noqsi/Mcadam/ICD/State.png

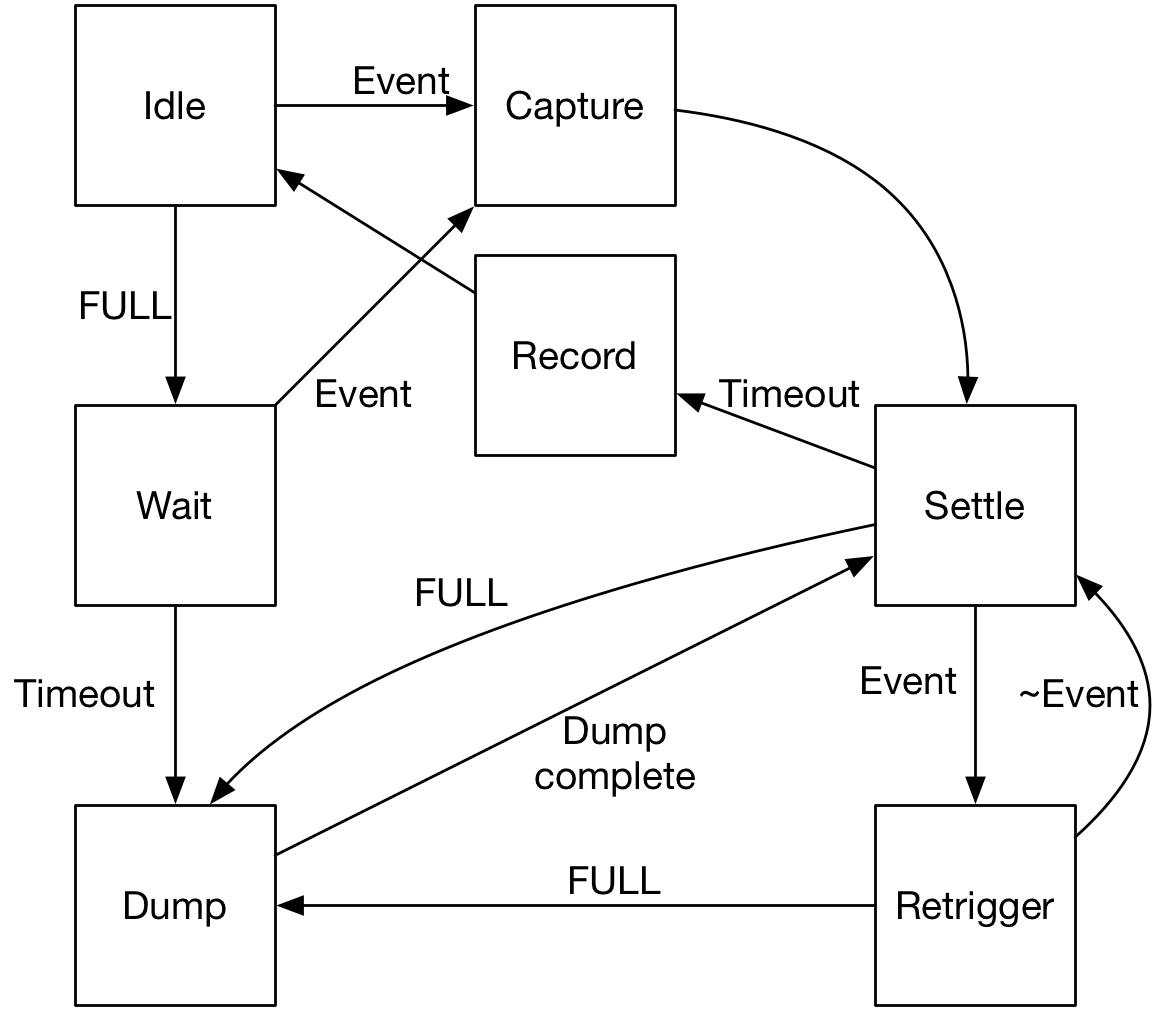
ICD/State.png
