noqsi/Mcadam/GSE/Doc/GSEhookup.graffle.pdf

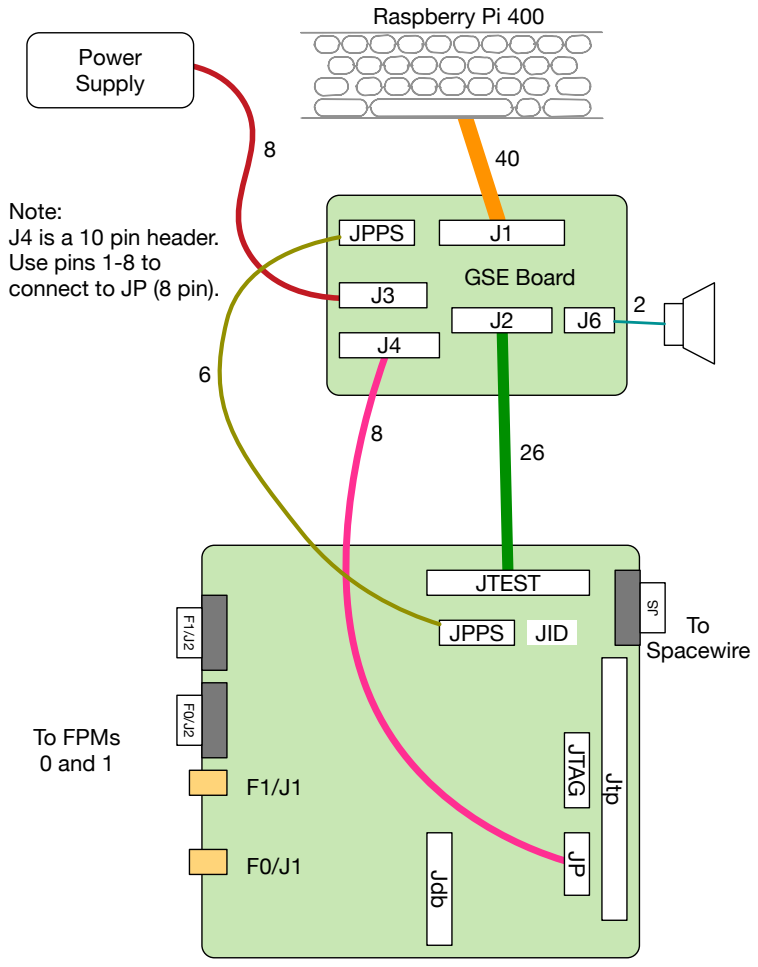
[picture p2: page 1]
JPPS; Raspberry Pi 400; GSE Board; JTEST; Jtp; JTAG; JID; Jdb; Power Supply; To FPMs 0 and 1; To Spacewire

Note:
J4 is a 10 pin header.
Use pins 1-8 to
connect to JP (8 pin).
