noqsi/Mcadam/ICD/test_if.txt

//============================================================================//
//--- Module Name: test_if
//
//--- Description: GSE Test Interface
//
// Test connector
// - pin  1 input  SPI0_MOSI
// - pin  2 output SPI0_MISO
// - pin  3 input  SPI0_SCLK
// - pin  4 input  SPI0_CE0_N
// - pin  5 input  SPI0_CE1_N
// - pin  6 input  SPI0_MOSI    - unused
// - pin  7 output SPI1_MISO
// - pin  8 input  SPI1_SCLK
// - pin  9 input  SPI1_CE0_N
// - pin 10 input  FORCE0       - pulse to force FPM0 event
// - pin 11 input  FORCE1       - pulse to force FPM1 event
// - pin 12 output EVENT_RDY    - goes high when event ready; low after SPI1 readout
// - pin 13 input  TEST_ENABLE  - set high to enable test interface
//
// GSE is SPI master, FPGA is slave
//
// SPI0 *****************************************
// - 16-bit transfers
// - CE0 : MOSI=ADR_REG  MISO=ADR_REG(last)
// - CE1 : MOSI=WR_REG   MISO=RD_REG
//
// ADR_REG
//  bits 15-8: 8-bit WADR
//        7-0: 8-bit RADR
//
// ADR R/W Description
// x00 rw   null (no write)
// x01 rw   MODE
//           [    0] 0=off, 1=photons
// x02 rw   HV_CTRL
//           [    0] 0=off, 1=on
// x03 rw   DAC_DATA
//           [15: 0] AD5328 DAC data
// x10 rw   FPM0_FAST_ADC_GAIN
//           [ 2: 0] 2^N ADC gain
// x11 rw   FPM0_FAST_ADC_OFFSET
//           [15: 0] 16-bit ADC offset
// x12 rw   FPM0_SLOW_ADC_GAIN
// x13 rw   FPM0_SLOW_ADC_OFFSET
// x20 rw   FPM1_FAST_ADC_GAIN
// x21 rw   FPM1_FAST_ADC_OFFSET
// x22 rw   FPM1_SLOW_ADC_GAIN
// x23 rw   FPM1_SLOW_ADC_OFFSET
// x30 r    HK_0_0 (FLLD-0)
// x31 r    HK_0_1 (SLLD-0)
// x32 r    HK_0_2 (TEMP-0)
// x33 r    HK_0_3 (HOT-0)
// x34 r    HK_0_4 (HVHK-0)
// x35 r    HK_0_5 (TIS-0)
// x36 r    HK_0_6 (TVS-0)
// x37 r    HK_0_7 (unused)
// x38 r    HK_1_0 (FLLD-1)
// x39 r    HK_1_1 (SLLD-1)
// x3A r    HK_1_2 (TEMP-1)
// x3B r    HK_1_3 (HOT-1)
// x3C r    HK_1_4 (HVHK-1)
// x3D r    HK_1_5 (TIS-1)
// x3E r    HK_1_6 (TVS-1)
// x3F r    HK_1_7 (unused)
//
//
// SPI1 *****************************************
// - 64-bit transfers
// - CE0 : MOSI=n/a      MISO=EVT_PKT
//
// EVT_PKT
//  [63:61] fpm_id
//  [60:36] mpu_time
//  [35:24] slow_ph
//  [23:12] fast_ph
//  [11: 5] dead_time
//  [    4] slow_flag
//  [    3] fast_flag
//  [    2] force_flag
//  [    1] over_flag
//  [    0] dump_flag
