noqsi/Mcadam/(commit log)

2020-07-27 first design files
    [FPM.1.sch, FPM.2.sch, FastShaper.1.sch, FastShaper.2.sch, SlowShaper.1.sch, SlowShaper.2.sch]
2020-08-02 importing and adjusting old designs
    [Chain.sch, FPM.1.sch, FPM.2.sch, FastShaper.1.sch, FastShaper.2.sch, HV.sch, HVregulator.sch, SlowShaper.2.sch]
2020-08-03 4V ADC reference
    [Reference.sch, SlowShaper.1.sch, SlowShaper.2.sch]
2020-08-12 PerFPM, Reference, and nits they revealed
    [Chain.sch, FPM.1.sch, FastShaper.2.sch, PerFPM.sch, Reference.sch, SlowShaper.2.sch]
2020-08-17 working on top level
    [Mcadam.1.sch, Mcadam.2.sch, Mcadam.3.sch, PerFPM.sch]
2020-08-27 Complete top level
    [FPM.1.sch, FPM.2.sch, Mcadam.1.sch, Mcadam.2.sch, Mcadam.3.sch, Mcadam.4.sch, PerFPM.sch, collectedPins.sch]
2020-08-27 FPGA pins
    [ProASICpins.tsv, collectedPins.sch]
2020-08-27 ProASIC regulated power
    [Mcadam.3.sch]
2020-08-27 add FPGA symbols
    [Mcadam.1.sch, Mcadam.2.sch, Mcadam.3.sch, Mcadam.4.sch]
2020-08-27 First cut at proper refdeses
    [FastShaper.2.sch, Mcadam.1.sch, Mcadam.2.sch, Mcadam.3.sch, Mcadam.4.sch, SlowShaper.2.sch]
2020-08-27 Reformat for pins2gsch
    [ProASICpins.tsv]
2020-08-28 Initial Makefile can make PDFs
    [FPM.1.sch, FPM.2.sch, Reference.sch]
2020-08-28 makes PDFs and BOM without reporting errors
    [FastShaper.2.sch, HV.sch, Mcadam.2.sch, Mcadam.3.sch, PerFPM.sch, SlowShaper.2.sch]
2020-08-29 Checks and builds without error
    [FPM.1.sch, FPM.2.sch, FastShaper.2.sch, Mcadam.1.sch, Mcadam.2.sch, Mcadam.3.sch, Mcadam.4.sch, PerFPM.sch]
2020-08-30 More consistent components
    [FPM.1.sch, FPM.2.sch, FastShaper.1.sch, FastShaper.2.sch, HVregulator.sch, Mcadam.2.sch, Mcadam.3.sch, PerFPM.sch]
2020-08-30 A little cleanup
    [FPM.1.sch, FPM.2.sch, FastShaper.2.sch, Reference.sch, SlowShaper.1.sch, SlowShaper.2.sch, TECregulator.sch]
2020-08-31 fix footprint
    [FPM.1.sch, PerFPM.sch]
2020-09-01 fix PPS pin assignments
    [ProASICpins.tsv]
2020-09-19 More ICD
    [ProASICpins.tsv]
2021-01-18 FPM is a separate board
    [FPM.1.sch, FPM.2.sch]
2021-01-18 add PUR pin
    [ProASICpins.tsv]
2021-01-18 Finish board split. Add PUR circuit
    [Mcadam.1.sch, Mcadam.4.sch, Reference.sch]
2021-01-19 Make FPM power/control connector MDM9
    [PerFPM.sch]
2021-01-19 Finish split of FPM/MPU. Adjust time constants. Cleanup.
    [FastShaper.1.sch, MPU.1.sch, MPU.2.sch, MPU.3.sch, MPU.4.sch, SlowShaper.1.sch, SlowShaper.2.sch]
2021-01-20 fixed FPGA pin assignments
    [ProASICpins.tsv]
2021-01-20 FPGA bank 2 for test pins
    [ProASICpins.tsv]
2021-01-20 Test connector, layout notes
    [MPU.1.sch, MPU.3.sch, MPU.4.sch]
2021-01-20 give JTAG connector a footprint
    [MPU.4.sch]
2021-01-26 Fix cap spec
    [FPM.2.sch]
2021-01-29 deduplicate and reconcile BOM with available parts
    [FastShaper.1.sch, HV.sch, HVregulator.sch, MPU.1.sch, MPU.3.sch, PerFPM.sch, SlowShaper.1.sch, SlowShaper.2.sch]
2021-01-29 scrub parts list, add TP to inject VPUMP if necessary
    [MPU.3.sch, MPU.4.sch, parts.tsv]
2021-01-29 replace obsolete choke
    [parts.tsv]
2021-01-29 put uniform rev and date on schems
    [FPM.1.sch, FPM.2.sch, FastShaper.1.sch, FastShaper.2.sch, HV.sch, HVregulator.sch, MPU.1.sch, MPU.2.sch]
2021-02-08 fix C27 spec
    [FPM.2.sch]
2021-02-09 Sreaming Circuits BOM
    [HV.sch, MPU.1.sch, parts.tsv]
2021-02-17 board ID jumpers
    [MPU.1.sch, PerFPM.sch, ProASICpins.tsv, parts.tsv]
2021-02-19 Bias for temp diodes should be +2.5
    [PerFPM.sch]
2021-03-02 change temp diode currents, add PUR pull-down diode
    [MPU.4.sch, PerFPM.sch, parts.tsv]
2021-03-02 fix pin functions
    [MPU.1.sch, ProASICpins.tsv]
2021-03-09 separate SCK for fast and slow, 50MHz osc
    [MPU.1.sch, PerFPM.sch, ProASICpins.tsv, parts.tsv]
2021-08-20 GSE stuff
    [GSEboard.sch]
2022-03-09 test connector stuff
2022-03-10 GSE connector doc for actual FPGA
2022-03-17 Pull down TEST_ENABLE, other measures to avoid problems with independent power"
    [GSEboard.sch]
2022-03-21 Click is GPIO 2
    [GSEboard.sch]
2022-03-21 fix click bit #
    [gpio.h]
2022-03-22 Disconnect Pi +5V from MPU +5V
    [GSEboard.sch]
2022-04-12 Revert to using GPIO 17 for FORCE0.
    [gpio.h]
2022-04-26 PPS driver
    [GSEboard.1.sch, GSEboard.2.sch]
2022-08-10 Connectors for debugging
    [Jdb.tsv, Jtp.tsv, ProASICpins.tsv]
2022-08-10 temprarily remove ICD/GSE-connector.md
2022-08-11 Schematic changes for next version
    [HVregulator.sch, MPU.1.sch, MPU.5.sch]
2022-08-11 Pass DRC checks
    [MPU.1.sch, MPU.5.sch]
2022-08-12 clean up attributes
    [FastShaper.1.sch, FastShaper.2.sch, MPU.1.sch, MPU.2.sch, MPU.3.sch, MPU.4.sch, MPU.5.sch, PerFPM.sch]
2022-08-12 Clean up MPU title blocks
    [MPU.1.sch, MPU.2.sch, MPU.3.sch, MPU.4.sch, MPU.5.sch]
2022-08-16 Update GSE board for PCB layout
    [GSEboard.1.sch, GSEboard.2.sch]
2022-08-17 New parts and new part attributes
    [parts.tsv]
2022-08-26 A few missing GSE board files
    [pincounts.tsv]
2022-08-26 Update Digikey part numbers
    [MPU.1.sch, MPU.4.sch, TECregulator.sch, parts.tsv]
2022-08-28 GSE bom for Screaming
2022-08-30 Screaming BOM for GSE board
    [parts.tsv]
2022-08-30 Fix symversion
    [GSEboard.2.sch]
2022-08-30 Fix symbol versions and .gitignore
    [MPU.3.sch]
2023-04-29 Fix names of LED signals
    [ProASICpins.tsv]
2023-04-29 RS422 interface
    [MPU.1.sch, MPU.5.sch, ProASICpins.tsv]
2023-04-29 3.3V transceiver
    [MPU.5.sch]
2023-05-04 fix event byte order
    [lexagse.c]
2023-08-06 calibration associations
2023-08-08 calibrated hk
2023-08-12 changes for spin 3 of MPU
    [HV.sch, HVregulator.sch, MPU.2.sch, PerFPM.sch, SlowShaper.2.sch, TECregulator.sch]
2023-08-14 more hysteresis and reference filtering
    [FastShaper.1.sch, FastShaper.2.sch, MPU.2.sch, Reference.sch, SlowShaper.1.sch, SlowShaper.2.sch]
2023-08-16 shaper tuneup and change to TRIG input
    [FastShaper.1.sch, FastShaper.2.sch, SlowShaper.1.sch, SlowShaper.2.sch]
2023-09-14 New BOM, new format
    [FastShaper.2.sch, HVregulator.sch, parts.tsv]
2023-09-16 complete parts database
    [parts.tsv]
